electricalhog/ExpansionCards/Electrical/KiCad_templates/Expansion_Card_Retrofit/Expansion_Card_rs-probe.png

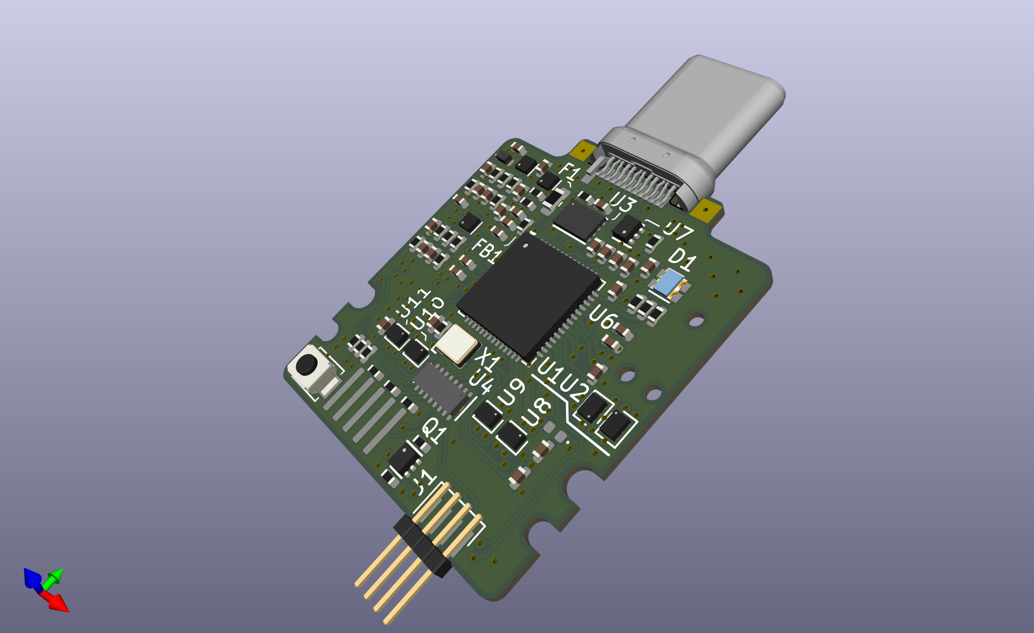
Electrical/KiCad_templates/Expansion_Card_Retrofit/Expansion_Card_rs-probe.png
