electricalhog/ExpansionCards/Electrical/KiCad_templates/Expansion_Card_Retrofit/Expansion_Card_rs-probe.dxf

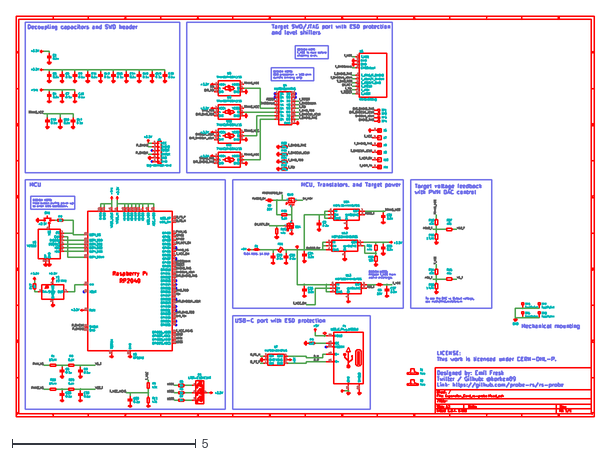
[picture p2: CAD file, 2025-02-18]
Electrical/KiCad_templates/Expansion_Card_Retrofit/Expansion_Card_rs-probe.dxf
15.7 x 10.9
