electricalhog/ExpansionCards/Electrical/KiCad_templates/Expansion_Card_Retrofit/Expansion_Card_rs-probe.pdf

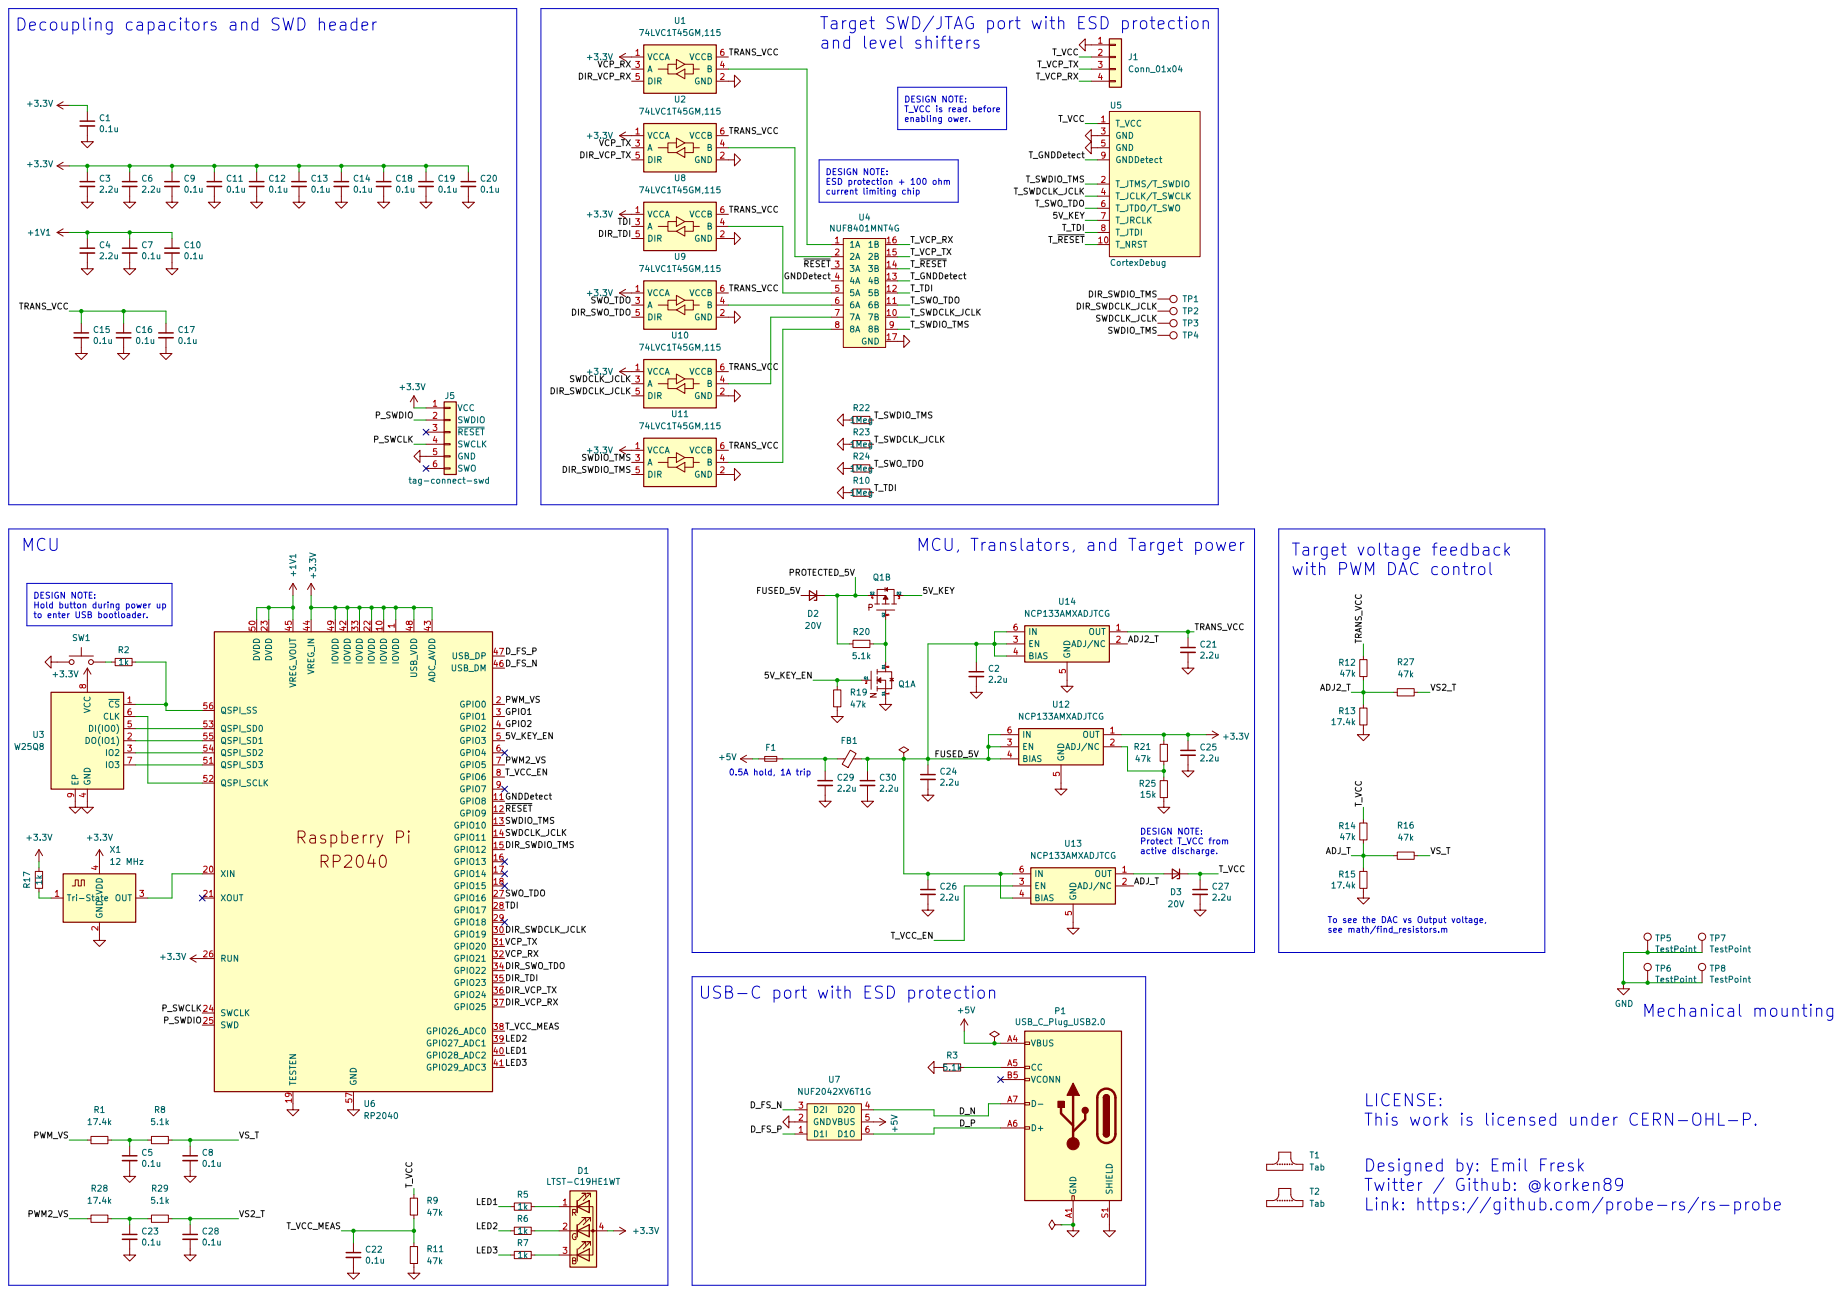
[picture p3: page 1]
