electricalhog/ExpansionCards/Electrical/KiCad_templates/Expansion_Card_Retrofit/Expansion_Card_rs-probe.kicad_pcb

## KiCad design Electrical/KiCad_templates/Expansion_Card_Retrofit/Expansion_Card_rs-probe.kicad_pcb (2025-06-01)

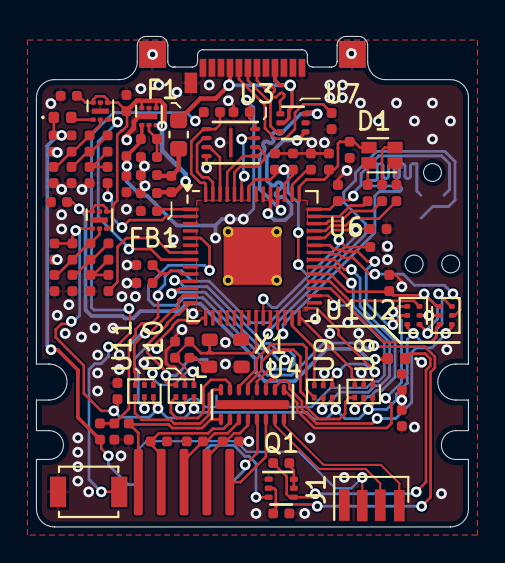
[picture p4: board Expansion_Card_rs-probe.kicad_pcb from above]

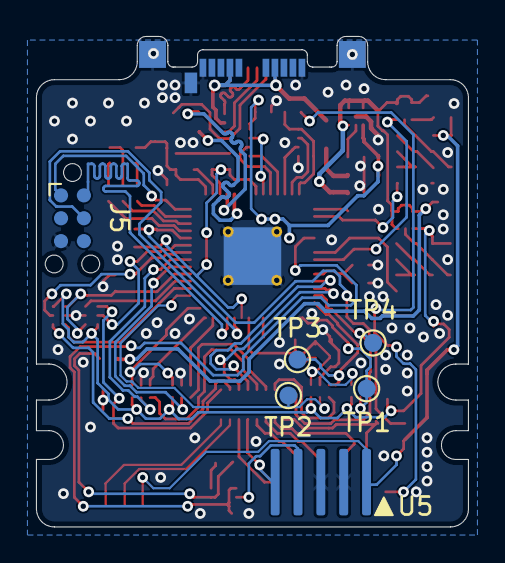
[picture p5: board Expansion_Card_rs-probe.kicad_pcb from below]

Board: 2 copper layers, 24.0 x 27.3 mm, 91 parts (8 on the bottom side), 74 nets.

Parts:
C1, C5, C7, C8, C9, C10, C11, C12, C13, C14, C15, C16, C17, C18, C19, C20, C22, C23, C28: 0.1u; C_0402
C2, C3, C4, C6, C21, C24, C25, C26, C27, C29, C30: 2.2u; C_0402
D1: LTST-C19HE1WT; LED_LiteOn_LTST-C19HE1WT
D2, D3: 20V; D_0402_1005Metric
F1: Fuse_Small; Fuse_0603_1608Metric
FB1: BLM15AX601SN1D; R_0402
J1: Conn_01x04; PinHeader_1x04_P1.00mm_Vertical_SMD_Pin1Left
J5: tag-connect-swd; Tag-Connect_TC2030-IDC-NL_2x03_P1.27mm_Vertical
P1: USB_C_Plug_USB2.0; USB_C_Plug_Molex_105444
Q1: NTZD3155C or CMLDM3757-TR-PBFREE or DMC2400UV-7 o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; SOT-563
R1, R13, R15, R28: 17.4k; R_0402
R2, R5, R6, R7, R17: 1k; R_0402
R3, R8, R20, R29: 5.1k; R_0402
R9, R11, R12, R14, R16, R19, R21, R27: 47k; R_0402
R10, R22, R23, R24: 1Meg; R_0402
R25: 15k; R_0402
SW1: B3U-1000P; SW_SPST_B3U-1000P
T1, T2: Tab
TP1, TP2, TP3, TP4: TestPoint; TestPoint_Pad_D1.0mm
TP5, TP6, TP7, TP8: TestPoint; TestPoint_Pad_1.5x1.5mm
U1, U2, U8, U9, U10, U11: 74LVC1T45GM,115; SOT-886
U3: W25Q8; USON-8-3x2mm-EP
U4: NUF8401MNT4G; DFN-16-1EP_1.6x4mm_P0.5mm
U5: CortexDebug; SHF-105-01-PCBEdge
U6: RP2040; QFN-56-1EP_7x7mm_P0.4mm_EP3.2x3.2mm_ThermalVias
U7: NUF2042XV6T1G; SOT-563
U12, U13, U14: NCP133AMXADJTCG; DFN-6-1EP_1.2x1.2mm_P0.4mm_EP0.3x0.94mm_PullBack
X1: 12 MHz; Crystal_SMD_2520-4Pin_2.5x2.0mm

Connections:
+1V1: C4.1, C7.1, C10.1, U6.23 (DVDD), U6.45 (VREG_VOUT), U6.50 (DVDD)
+3.3V: C1.1, C3.1, C6.1, C9.1, C11.1, C12.1, C13.1, C14.1, C18.1, C19.1, C20.1, C25.1, D1.4 (A), J5.1 (VCC), R17.1, R21.2, U1.1 (VCCA), U2.1 (VCCA), U3.8 (VCC), U6.1 (IOVDD), U6.10 (IOVDD), U6.22 (IOVDD), U6.26 (RUN), U6.33 (IOVDD), U6.42 (IOVDD), U6.43 (ADC_AVDD), U6.44 (VREG_IN), U6.48 (USB_VDD), U6.49 (IOVDD), U8.1 (VCCA), U9.1 (VCCA), U10.1 (VCCA), U11.1 (VCCA), U12.1 (OUT), X1.4 (VDD)
+5V: F1.1, P1.A4 (VBUS), P1.A9 (VBUS), P1.B4 (VBUS), P1.B9 (VBUS), U7.5 (VBUS)
/5V_KEY: Q1.3 (D2), U5.7 (T_JRCLK)
/5V_KEY_EN: Q1.2 (G1), R19.2, U6.5 (GPIO3)
/ADJ2_T: R12.1, R13.2, R27.1, U14.2 (ADJ/NC)
/ADJ_T: R14.1, R15.2, R16.1, U13.2 (ADJ/NC)
/DIR_SWDCLK_JCLK: TP2.1, U6.30 (GPIO19), U10.5 (DIR)
/DIR_SWDIO_TMS: TP1.1, U6.15 (GPIO12), U11.5 (DIR)
/DIR_SWO_TDO: U6.34 (GPIO22), U9.5 (DIR)
/DIR_TDI: U6.35 (GPIO23), U8.5 (DIR)
/DIR_VCP_RX: U1.5 (DIR), U6.37 (GPIO25)
/DIR_VCP_TX: U2.5 (DIR), U6.36 (GPIO24)
/D_FS_N: U6.46 (USB_DM), U7.3 (D2I)
/D_FS_P: U6.47 (USB_DP), U7.1 (D1I)
/D_N: P1.A7 (D-), U7.4 (D2O)
/D_P: P1.A6 (D+), U7.6 (D1O)
/FUSED_5V: C2.1, C24.1, C26.1, C30.1, D2.2 (A), FB1.2, U12.3 (EN), U12.4 (BIAS), U12.6 (IN), U13.4 (BIAS), U13.6 (IN), U14.3 (EN), U14.4 (BIAS), U14.6 (IN)
/GNDDetect: U4.4 (4A), U6.11 (GPIO8)
/LED1: R5.2, U6.40 (GPIO28_ADC2)
/LED2: R6.2, U6.39 (GPIO27_ADC1)
/LED3: R7.2, U6.41 (GPIO29_ADC3)
/PROTECTED_5V: D2.1 (K), Q1.4 (S2), R20.2
/PWM2_VS: R28.2, U6.7 (GPIO5)
/PWM_VS: R1.2, U6.2 (GPIO0)
/P_SWCLK: J5.4 (SWCLK), U6.24 (SWCLK)
/P_SWDIO: J5.2 (SWDIO), U6.25 (SWD)
/SWDCLK_JCLK: TP3.1, U6.14 (GPIO11), U10.3 (A)
/SWDIO_TMS: TP4.1, U6.13 (GPIO10), U11.3 (A)
/SWO_TDO: U6.27 (GPIO16), U9.3 (A)
/TDI: U6.28 (GPIO17), U8.3 (A)
/TRANS_VCC: C15.1, C16.1, C17.1, C21.1, R12.2, U1.6 (VCCB), U2.6 (VCCB), U8.6 (VCCB), U9.6 (VCCB), U10.6 (VCCB), U11.6 (VCCB), U14.1 (OUT)
/T_GNDDetect: U4.13 (4B), U5.9 (GNDDetect)
/T_SWDCLK_JCLK: R23.2, U4.10 (7B), U5.4 (T_JCLK/T_SWCLK)
/T_SWDIO_TMS: R22.2, U4.9 (8B), U5.2 (T_JTMS/T_SWDIO)
/T_SWO_TDO: R24.2, U4.11 (6B), U5.6 (T_JTDO/T_SWO)
/T_TDI: R10.2, U4.12 (5B), U5.8 (T_JTDI)
/T_VCC: C27.1, D3.1 (K), J1.2, R9.1, R14.2, U5.1 (T_VCC)
/T_VCC_EN: U6.8 (GPIO6), U13.3 (EN)
/T_VCC_MEAS: C22.1, R9.2, R11.1, U6.38 (GPIO26_ADC0)
/T_VCP_RX: J1.4, U4.16 (1B)
/T_VCP_TX: J1.3, U4.15 (2B)
/T_~RESET: U4.14 (3B), U5.10 (T_NRST)
/VCP_RX: U1.3 (A), U6.32 (GPIO21)
/VCP_TX: U2.3 (A), U6.31 (GPIO20)
/VS2_T: C28.1, R27.2, R29.1
/VS_T: C8.1, R8.1, R16.2
/~RESET: U4.3 (3A), U6.12 (GPIO9)
GND: C1.2, C2.2, C3.2, C4.2, C5.2, C6.2, C7.2, C8.2, C9.2, C10.2, C11.2, C12.2, C13.2, C14.2, C15.2, C16.2, C17.2, C18.2, C19.2, C20.2, C21.2, C22.2, C23.2, C24.2, C25.2, C26.2, C27.2, C28.2, C29.2, C30.2, J1.1, J5.5 (GND), P1.A1 (GND), P1.A12 (GND), P1.B1 (GND), P1.B12 (GND), P1.S1 (SHIELD), Q1.1 (S1), R3.2, R10.1, R11.2, R13.1, R15.1, R19.1, R22.1, R23.1, R24.1, R25.1, SW1.1, TP5.1, TP6.1, TP7.1, TP8.1, U1.2 (GND), U2.2 (GND), U3.4 (GND), U3.9 (EP), U4.17 (GND), U5.3 (GND), U5.5 (GND), U6.19 (TESTEN), U6.57 (GND), U7.2 (GND), U8.2 (GND), U9.2 (GND), U10.2 (GND), U11.2 (GND), U12.5 (GND), U12.7 (GND), U13.5 (GND), U13.7 (GND), U14.5 (GND), U14.7 (GND), X1.2 (GND)
unnamed: C5.1, R1.1, R8.2
unnamed: C23.1, R28.1, R29.2
unnamed: C29.1, F1.2, FB1.1
unnamed: D1.3 (BK), R7.1
unnamed: D1.2 (GK), R6.1
unnamed: D1.1 (RK), R5.1
unnamed: D3.2 (A), U13.1 (OUT)
unnamed: P1.A5 (CC), R3.1
unnamed: Q1.5 (G2), Q1.6 (D1), R20.1
unnamed: R2.2, SW1.2
unnamed: U1.4 (B), U4.1 (1A)
unnamed: U2.4 (B), U4.2 (2A)
unnamed: U3.6 (CLK), U6.52 (QSPI_SCLK)
unnamed: U3.5 (DI(IO0)), U6.53 (QSPI_SD0)
unnamed: U3.2 (DO(IO1)), U6.55 (QSPI_SD1)
unnamed: U3.3 (IO2), U6.54 (QSPI_SD2)
unnamed: U3.7 (IO3), U6.51 (QSPI_SD3)
unnamed: R2.1, U3.1 (~CS), U6.56 (QSPI_SS)
unnamed: U4.5 (5A), U8.4 (B)
unnamed: U4.6 (6A), U9.4 (B)
unnamed: U6.20 (XIN), X1.3 (OUT)
unnamed: U4.7 (7A), U10.4 (B)
unnamed: U4.8 (8A), U11.4 (B)
unnamed: R21.1, R25.2, U12.2 (ADJ/NC)
unnamed: R17.2, X1.1 (Tri-State)
