electricalhog/ExpansionCards/(commit log)

2024-07-15 airwires solved
    [Expansion_Card_rs-probe.kicad_pcb, Expansion_Card_rs-probe.kicad_sch]
2024-07-15 silkscreen and DRC progress
    [Expansion_Card_rs-probe.kicad_pcb]
2025-02-18 images and models
    [Expansion_Card_rs-probe.dxf, Expansion_Card_rs-probe.kicad_pcb, Expansion_Card_rs-probe.kicad_sch]
2025-03-19 VCP and 3d models
    [Expansion_Card_rs-probe-B_Adhesive.gbr, Expansion_Card_rs-probe-B_Cu.gbr, Expansion_Card_rs-probe-B_Mask.gbr, Expansion_Card_rs-probe-B_Paste.gbr, Expansion_Card_rs-probe-B_Silkscreen.gbr, Expansion_Card_rs-probe-Edge_Cuts.gbr, Expansion_Card_rs-probe-F_Adhesive.gbr, Expansion_Card_rs-probe-F_Cu.gbr]
2025-06-01 v0 ordered
    [Expansion_Card_rs-probe-B_Adhesive.gbr, Expansion_Card_rs-probe-B_Cu.gbr, Expansion_Card_rs-probe-B_Mask.gbr, Expansion_Card_rs-probe-B_Paste.gbr, Expansion_Card_rs-probe-B_Silkscreen.gbr, Expansion_Card_rs-probe-Edge_Cuts.gbr, Expansion_Card_rs-probe-F_Adhesive.gbr, Expansion_Card_rs-probe-F_Cu.gbr]
