electricalhog/ExpansionCards/(notices)

Notices in the files:
Electrical/KiCad_templates/Expansion_Card_Retrofit/Expansion_Card_rs-probe.kicad_pcb:
This work is licensed under a Creative Commons Attribution 4.0 International License
